SrFatCat/LeakSensor/(commit log)

2020-03-12 Старт с калманом
2020-03-12 Вместо калмана - усреднение
2020-03-15 Версия 1.0 готово
2020-03-15 Добавлено описание
2020-03-15 Работа над readme
